sai021/dragon-kingdom/keeper-edition-draft/README.md

# Archived keeper-edition draft

These files preserve a design draft included in the 23 October 2026 checkpoint.
They are not the current firmware interface or user instructions, and the demo
does not constitute physical device evidence.

Edit the active web sources in `../dragon-firmware/web/` and the current manual
in `../docs/USER-MANUAL.md`. See `../docs/PROJECT-STATUS.md` for current evidence
and pending hardware files.
