sai021/dragon-kingdom/dragon-firmware/hardware/supplied-2026-10-23/README.md

# User-supplied hardware files — 23 October 2026

The user supplied these nine files for publication. Original filenames and
bytes are preserved; `SHA256SUMS.txt` records verified attachment checksums.
The BOM and Gerber filenames retain their 21 September 2026 dates. The intake
date does not establish a newer PCB revision or manufacturing approval.

- `BOM_Dragon-Lamp_2_PCB1_1_2026-09-21.xlsx`
- `Gerber_PCB1_1_2026-09-21_2.zip`
- `BackCover 2.stl`
- `UsbNuts 2.stl`
- `Lithophanev2.stl`
- `LithophaneJig.stl`
- `electronicsPlate.stl`
- `LightGuide.stl`
- `NightLamp.f3d` — native Fusion design archive supplied with the exports.

The Fusion archive, six STL exports, BOM and Gerbers are kept together as the
supplied design package. The Fusion file has not been opened to verify component
coverage or external dependencies; completeness for fabrication is not yet checked.

These are supplied assets, not regenerated replacements for earlier prototypes.
Units, orientation, mesh integrity, PCB design checks, optical mapping and
physical fit have not been validated during this intake. Build photos remain
pending. No final-design or manufacturing approval is implied. Existing asset
provenance and licence limitations continue to apply.
