sai021/dragon-kingdom/dragon-firmware/hardware/supplied-2026-10-23/BOM_Dragon-Lamp_2_PCB1_1_2026-09-21.xlsx

No. | Quantity | Comment | Designator | Footprint | Value | Manufacturer Part | Manufacturer | Supplier Part | Supplier
1 | 2 | 100nF | 100nf3,100nf4 | CAP-TH_L5.0-W2.5-P5.00-D1.0 | 100nF | CC1H104MC1FD3F6C10MF | Dersonic(德尔创) | C254085 | LCSC
2 | 1 | HDGCPH254-PW01-08 | J1 | HDR-TH_8P-P2.54-H-M-W10.4 |  | HDGCPH254-PW01-08 | HDGC(华德共创) | C20607071 | LCSC
3 | 1 | HDGCPH254-PW01-10 | J4 | HDR-TH_10P-P2.54-H-M-W10.4 |  | HDGCPH254-PW01-10 | HDGC(华德共创) | C20607072 | LCSC
4 | 1 | 330Ω | r1_330 | RES-TH_BD2.3-L6.3-P10.30-D0.6 | 330Ω | LR1F330R | TE Connectivity(泰科电子) | C1367485 | LCSC
5 | 1 | 10kΩ | r3_10k | RES-TH_BD2.5-L6.5-P10.50-D0.6 | 10kΩ | MFR0W4F1002A50 | UNI-ROYAL(厚声) | C57436 | LCSC
6 | 1 | 100kΩ | r4_100k | RES-TH_BD2.5-L6.5-P10.50-D0.6 | 100kΩ | MFR0W4F1003A50 | UNI-ROYAL(厚声) | C58597 | LCSC
7 | 1 | 20kΩ | r5_20k | RES-TH_BD2.2-L6.5-P10.50-D0.6 | 20kΩ | MFR0W4F2002A50 | UNI-ROYAL(厚声) | C58594 | LCSC
