sai021/dragon-kingdom/dragon-firmware/hardware/supplied-2026-10-23/Lithophanev2.stl

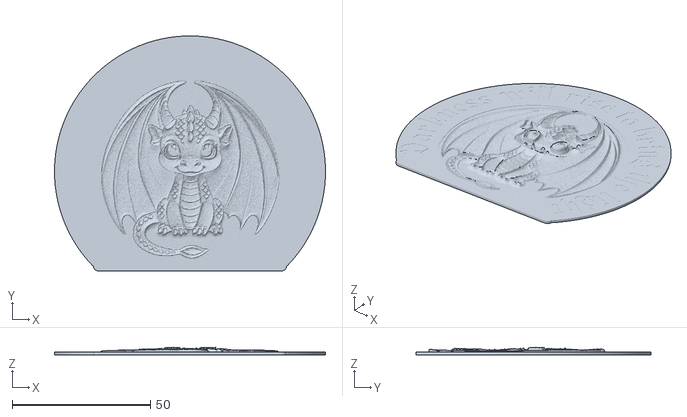
[picture p1: CAD file, 2026-10-23]
dragon-firmware/hardware/supplied-2026-10-23/Lithophanev2.stl
98.0 x 85.0 x 2.74
