sai021/dragon-kingdom/dragon-firmware/hardware/supplied-2026-10-23/BackCover 2.stl

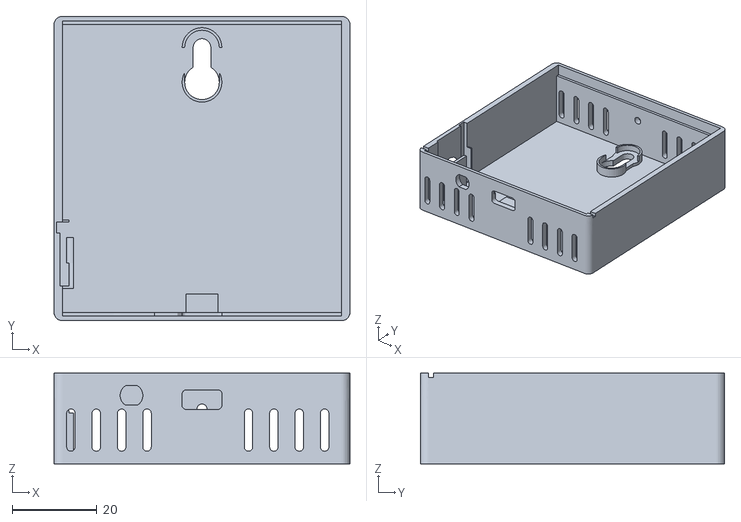
[picture p2: CAD file, 2026-10-23]
dragon-firmware/hardware/supplied-2026-10-23/BackCover 2.stl
70.0 x 72.0 x 21.5
