sai021/dragon-kingdom/dragon-firmware/hardware/supplied-2026-10-23/electronicsPlate.stl

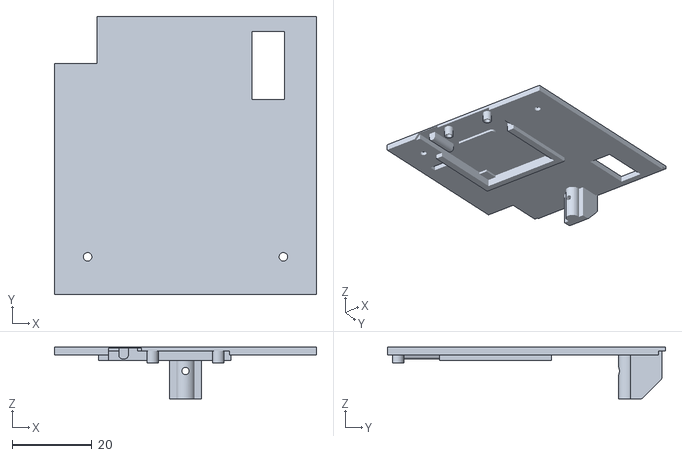
[picture p3: CAD file, 2026-10-23]
dragon-firmware/hardware/supplied-2026-10-23/electronicsPlate.stl
65.6 x 69.6 x 13.0
