sai021/dragon-kingdom/dragon-firmware/hardware/supplied-2026-10-23/LithophaneJig.stl

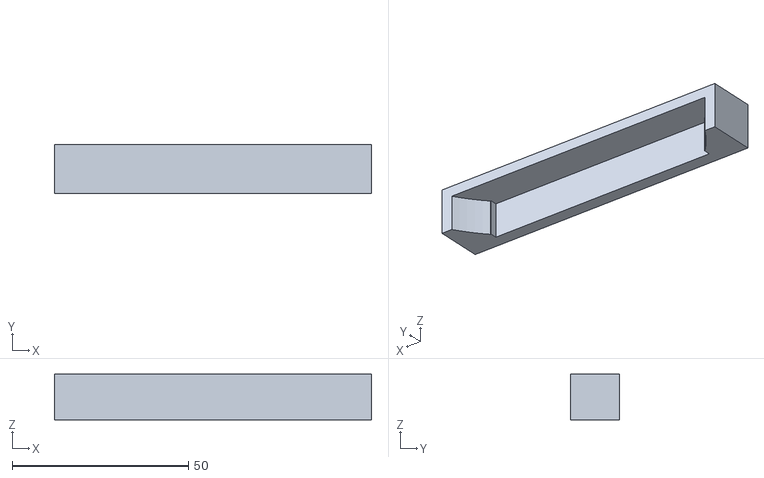
[picture p4: CAD file, 2026-10-23]
dragon-firmware/hardware/supplied-2026-10-23/LithophaneJig.stl
90.0 x 14.0 x 13.0
