sai021/dragon-kingdom/dragon-firmware/hardware/supplied-2026-10-23/UsbNuts 2.stl

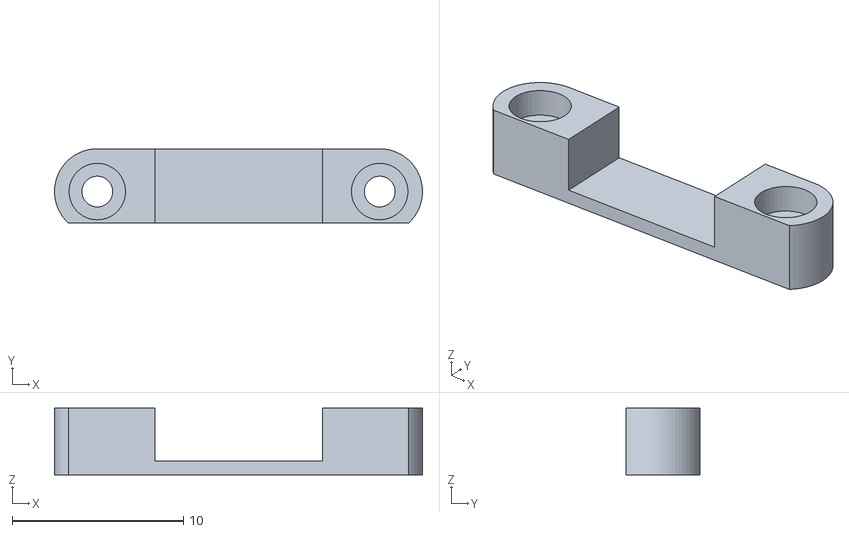
[picture p5: CAD file, 2026-10-23]
dragon-firmware/hardware/supplied-2026-10-23/UsbNuts 2.stl
21.5 x 4.35 x 3.90
