sai021/dragon-kingdom/dragon-firmware/hardware/supplied-2026-10-23/LightGuide.stl

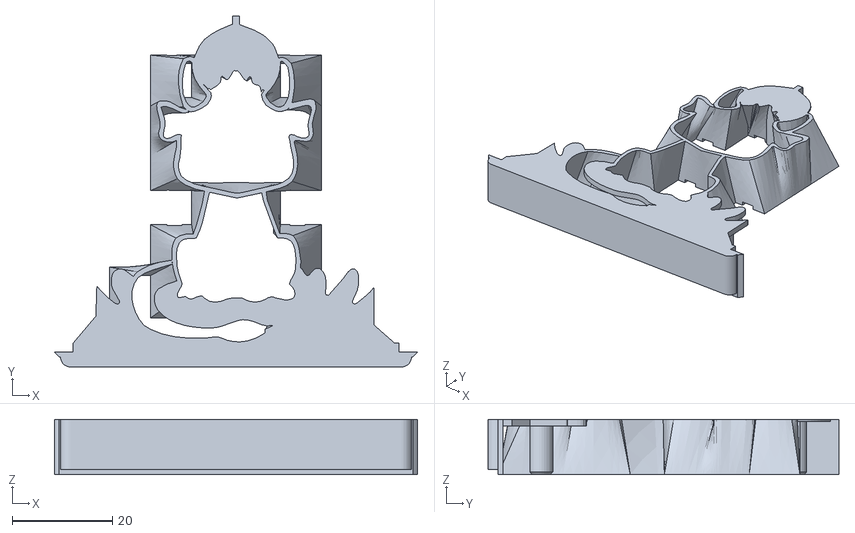
[picture p6: CAD file, 2026-10-23]
dragon-firmware/hardware/supplied-2026-10-23/LightGuide.stl
72.4 x 70.0 x 11.0
