sai021/dragon-kingdom/(list of files, cad)

Other CAD files:
dragon-firmware/hardware/supplied-2026-10-23/NightLamp.f3d
