sai021/dragon-kingdom/keeper-edition-draft/USER-MANUAL.md

# Dragon Kingdom

The Care and Training of Your Wall Dragon — for a young keeper and their grown-ups

## Item 1: Do not plug in your dragon before reading this

Congratulations! You are now the keeper of a genuine, pedigreed **Wall Dragon**. Unlike wild dragons, which take up three bedrooms and set the curtains on fire, a domesticated Wall Dragon needs only a single screw head on a wall and a steady 5 V snack through the USB power port at the bottom.

Your new dragon is a sensitive creature and performs a strict waking ritual whenever power is connected. **Do not rush a waking dragon:**

1. Ask a grown-up to hang your dragon on its wall screw and connect the power supply provided or specified by your maker.
2. Watch its snout: first, it blinks **one dim blue eye five times** to make sure the wall has not moved.
3. Next, it lights a few white bars along the bottom. **It is testing the strength of the cord** so it never drinks more power than your supply can spare. After holding those bars for two seconds of quiet pride, your dragon wakes in full colour.

## Know your dragon (79 breeds in one)

Your dragon didn't hatch out of just any boulder! Because keeping seventy-nine full-sized dragons in one bedroom is frowned upon, your Wall Dragon is trained in **Chameleon Shifting**. With a single pat, it can channel **79 famous dragons** from the tribes—plus up to **eight rare hybrids** invented by you.

**Keep your setup card.** It has your dragon's Wi-Fi name. Its setup password is **dragon123** (all lowercase).

<!-- page -->

# Simple obedience

Section One — basic manners and bedroom etiquette

## Training your dragon

Nobody likes a surly, misbehaving dragon. Limit your early training sessions to fifteen minutes twice a day. Amazingly, a Wall Dragon responds to training without a leash, muzzle, or fire extinguisher.

- **STAY:** Hang your dragon on its wall screw, look it squarely in the snout, and say, **STAY**. Incredibly, your dragon will obey on the very first try. Peek back into the room an hour later and you will find it is still on the wall. Praise your dragon.
- **COME:** Stand across the room and call your dragon's name. Assuming it is properly hung on its screw, it will not move. Do not give up; walk slowly toward the wall. Astonishingly, as you walk toward your dragon, you will notice it coming closer!
- **SPEAK & FETCH:** Don't be ridiculous. Wall Dragons have no ears, no feet, and a deep philosophical objection to barking. They speak entirely in light.

## Your three touch commands

Pat the touch sensor on your dragon to give it commands—no phone or internet required:

- **One pat (Next!):** Shifts into the next dragon in your collection, or wakes a sleeping dragon.
- **Two quick pats (Play Dead / Sleep):** Sends your dragon to sleep in a dark cave, or wakes it back up.
- **Long hold (Purr-Brighten / Dim):** Hold your finger on the pad to adjust its glow in small steps. Let go and hold again to go the other way.

## Nocturnal manners

Your dragon is not afraid of the dark. When you turn off the bedroom lights, it lowers its scales to a steady 10% ember to keep quiet watch while you sleep, and shines at full strength again by day.

<!-- page -->

# Connect a phone

Section Two — telepathy for grown-up keepers

## Open Dragon Kingdom

While your dragon is happy being patted on the nose forever without knowing what the internet is, grown-ups can speak to it through a phone browser. No app or coding is needed.

1. Wait for your dragon to finish its blue-eye waking ritual.
2. Open the phone's Wi-Fi settings and join the dragon network named on its setup card.
3. Enter **dragon123** (all lowercase).
4. If the phone warns that this network has no internet, choose **Stay connected**. (Dragons do not read emails.)
5. Open a browser and type **http://192.168.4.1** in the address bar.
6. Log in with username **parent** and password **dragon123**.

You can play and edit right away over the dragon's own network. Home Wi-Fi is optional. Updated firmware uses **dragon123** even if an older card shows a random password. Your home Wi-Fi keeps its own private password.

## Optional: teach it your home Wi-Fi

1. Open **For grown-ups · Wi-Fi & help** on the phone page.
2. Tap **Find my Wi-Fi**, then pick your **2.4 GHz** home network (or type its name if hidden).
3. Enter your home Wi-Fi password. Use **Show password** to check your spelling.
4. Tap **Connect my dragon** and wait for the result.
5. Copy the **.local** bookmark address that appears above the play controls (such as **http://Dragon-Kingdom-a1b2c3.local/**).
6. Switch your phone back to home Wi-Fi, open that address, and bookmark it. The page also shows a numeric fallback address.

<!-- page -->

# The dawn stretch

Section Three — teaching your dragon rooster duty

## Set your wake-up time

Roosters are noisy and drop feathers on the floor. A trained Wall Dragon wakes you silently by painting the wall behind its wings with sunrise light.

1. Open **Sunrise alarm** on the phone page and wait for its saved schedule to load.
2. Tick **Wake me every day**.
3. Choose your **Wake-up time** and **Sunrise length (minutes)**.
4. Tap **Save alarm** and check the confirmation message.

Your dragon begins warming its entire wings—from the lowest wing scales to the wing tips—from deep ember-orange to morning gold before wake-up time. For example, **7:00** with a **20-minute** sunrise starts at **6:40**.

It works even while the dragon is asleep. At wake-up time, the wings hold their morning glow for **30 minutes**, then return to their previous state. Available power still caps brightness, and the dragon never makes a sound.

## Rehearse or dismiss the sunrise

- **Try a 30-second sunrise** previews the dawn stretch, then returns to normal after a brief hold.
- **Stop sunrise** (or any pat / play button) tells your dragon "I'm awake!" without cancelling tomorrow's alarm.
- To turn off rooster duty completely, untick **Wake me every day** and tap **Save alarm**.

## Dragon timekeeping

Dragons do not wear wristwatches. Saving an alarm borrows the clock and daylight-saving rules from your phone. If unplugged, the dragon remembers your schedule, but after a power cut it needs home Wi-Fi internet time or this page opened again (**Set clock from my phone**) before it knows what hour it is. Open and save the alarm once a year or after changing time zones.

<!-- page -->

# Roosts and collections

Section Four — The Great Sanctuary and personal teams

## All or a personal roost

Every dragon lives in **All** (The Great Sanctuary). It holds all 79 pedigreed dragons plus every custom hybrid ever hatched on your device. By ancient dragon law, **All** cannot be renamed or deleted, and you can use it forever without making a profile.

If you want smaller hand-picked teams for different moods, use **My profile** to switch between up to **three named profiles** (personal roosts).

When a named profile is active, **My dragon** and single pats on the touch sensor cycle only through that profile's favourites and its own creations. The first dragon in the list greets you after startup.

## Build a personal roost

1. Open **My favourites & starting glow**.
2. Enter a **New profile name** and tap **Add profile**.
3. Tick up to **12** favourite dragons in the order you want them to appear. (Untick and tick again to move one to the end.)
4. Pick a **Starting glow**, then tap **Save profile**.

Your own creations appear right after your ticked favourites. A brand-new empty profile will say **Add favourites or make a dragon**, and play buttons rest until you put at least one dragon in that roost. Profiles and creations survive unplugging; temporary play tricks do not overwrite your saved startup glow.

## Closing a roost

To remove a named profile, select it, open its settings, and tap **Delete this profile**. Never worry about losing your hybrids: any custom dragons hatched in that roost fly safely back into **All**.

<!-- page -->

# Hatching a hybrid

Section Five — custom colours, body parts and elemental tricks

## Breed and save your own dragon

1. Tap **Make a dragon** and choose a starter breed in **Start from**.
2. Give your creation a **Dragon name**.
3. Tap a body region on the dragon picture, or pick one from **Dragon part**.
4. Choose its **Colour** and **Magic on this part** (such as Glitter, Shimmer, Breathe, or Rainbow).
5. Paint as many parts as you like, then tap **Save my dragon**.

You can colour the **face, body, tail, horns, wing edges, and wing interiors** separately. Untouched parts keep their natural markings, and **Use original colour for this part** restores a region's base scales.

Use the view switch under the picture to see your dragon's sculpted outline, the 64 lights, or both together. Tap **Save my dragon** to watch your creation come alive on the wall!

## Edit, copy, or retire a hybrid

- Select your dragon in **My dragon** and tap **Make a dragon** to groom or rename it.
- **Save my dragon** updates a hybrid you own; **Save a new copy** hatches a twin.
- Editing one of the 79 pedigreed dragons (or a hybrid from another profile) always saves a new copy so originals stay untouched.
- Your wall holds up to **eight custom dragons** in total. When all eight perches are full, edit or delete an old creation to make room.

## Amusing elemental tricks

On the play screen, tap **Glitter**, **Fire**, **Breathe**, or **Rainbow**. Your dragon will perform the trick tirelessly until you tap **Back to my dragon**. Use **Glow** to adjust brightness, or **Sleep / Wake my dragon** for nap time. Wait a beat for each trick to land before tapping the next button.

<!-- page -->

# Dragon health care

Section Six — moving house and first aid for common ailments

## Moving house (The Purple Nose-Hold)

If you change Wi-Fi routers or want a direct phone connection again, teach your dragon the **Purple Nose-Hold**:

1. Unplug the power cord from the bottom of the dragon.
2. Press and hold your finger on the touch pad while plugging the power back in.
3. Keep holding right through the five blue eye-blinks.
4. Let go when the dragon glows **purple** after startup.
5. Join the **Dragon-Kingdom-XXXXXX** Wi-Fi network with **dragon123** and open **http://192.168.4.1**.

This keeps your saved home Wi-Fi and creations intact. To erase home Wi-Fi completely, tap **Forget home Wi-Fi** in the grown-ups section.

## When your dragon seems confused

- **Phone says "no internet":** Completely normal on the dragon's private network. Stay connected and open **http://192.168.4.1**.
- **The .local bookmark won't open:** Make sure your phone is on the same home Wi-Fi as the dragon, or try its numeric address. Guest networks often forbid pets from talking to phones—use a regular home network or the Purple Nose-Hold.
- **Dragon Wi-Fi never appears:** If the power brick is weak, the dragon saves its energy for touch lighting and keeps Wi-Fi off. Ask a grown-up to check the power supply specified by the maker.
- **Page says "Please wait for your dragon":** You are tapping faster than a dragon can think! Let the current action finish.
- **Dragon is unexpectedly dark or blinking red:** Check **Sleep** and **Glow** first (remember it dims in dark rooms). If it shows a dim red code at startup or keeps restarting, unplug it and contact the maker.
- **Interrupted saves or lost time:** A failed save keeps your draft open in the editor. If the page asks to reload after a firmware update or collection change, note your unsaved colour choices first. If the alarm waits after a power cut, tap **Set clock from my phone**.

<!-- page -->

# Keeper's certificate

Section Seven — care rules and official registration

## Feeding and care (For grown-ups)

Always feed your dragon through the bottom USB power port using the power supply provided or specified by your maker. Keep your dragon indoors and dry, handle its cord gently, and never open its enclosure or attach unapproved power sources.

## A good dragon keeper remembers

Carved across your dragon's frame is the motto **Darkness will rise to bring the light**—every hard climb or quiet night comes right before you shine.

- **Touch play always works**—even without a phone, Wi-Fi, or internet.
- **Keep your setup card** and bookmark your dragon's **.local** address.
- **All** is the protected Great Sanctuary; named profiles are personal roosts.
- **Save your work** in the editor before unplugging the dragon.
- **Polite brightness:** Your dragon automatically adjusts its glow for dark bedrooms and the strength of its power supply, so 100% means "as bright as current conditions safely allow."
- Never throw your dragon across a pond, and never turn it loose in the wild. Remember: if you take care of your Wall Dragon, your Wall Dragon will chase away the dark for you.

## Official pedigree record

First dragon's name: ____________________________________

Keeper's name: __________________________________________

Phone bookmark (.local): ________________________________

Maker / Dragon healer contact: __________________________

Dragon Wi-Fi & browser password: **dragon123** (Browser username: **parent**). Keep your home Wi-Fi password private.

**About this edition:** Dragon Kingdom prototype user manual, version 0.5, 19 October 2026. It describes the current software interface while final enclosure details are completed by your maker.
