sai021/dragon-kingdom/output/setup/dragon-rear-labels.pdf

# Dragon Kingdom | shared rear labels

Print at 100% / Actual size. Cut on the outlines. Each label is 90 x 65 mm. Check space on your finished enclosure before printing adhesive stock.

## DRAGON KINGDOM

### Setup & manual Needs internet

### Open dragon Join dragon Wi-Fi first

Wi-Fi: Dragon-Kingdom-... | Password: dragon123
Play: no login | Parent settings: dragon123

## DRAGON KINGDOM

### Setup & manual Needs internet

### Open dragon Join dragon Wi-Fi first

Wi-Fi: Dragon-Kingdom-... | Password: dragon123
Play: no login | Parent settings: dragon123

## DRAGON KINGDOM

### Setup & manual Needs internet

### Open dragon Join dragon Wi-Fi first

Wi-Fi: Dragon-Kingdom-... | Password: dragon123
Play: no login | Parent settings: dragon123

## DRAGON KINGDOM

### Setup & manual Needs internet

### Open dragon Join dragon Wi-Fi first

Wi-Fi: Dragon-Kingdom-... | Password: dragon123
Play: no login | Parent settings: dragon123

## DRAGON KINGDOM

### Setup & manual Needs internet

### Open dragon Join dragon Wi-Fi first

Wi-Fi: Dragon-Kingdom-... | Password: dragon123
Play: no login | Parent settings: dragon123

## DRAGON KINGDOM

### Setup & manual Needs internet

### Open dragon Join dragon Wi-Fi first

Wi-Fi: Dragon-Kingdom-... | Password: dragon123
Play: no login | Parent settings: dragon123
