sai021/dragon-kingdom/output/setup/dragon-setup-card.pdf

# Welcome, dragon keeper!

One card for every dragon. No app or account needed.

### 1. Read first. Scan Setup & manual while your phone has internet. Then

power on one new dragon and wait for it to wake.

### 2. Join your dragon. In phone Wi-Fi settings, choose a network starting

Dragon-Kingdom-. Password: dragon123. If asked, stay connected without internet.

### 3. Open controls. The setup page may appear automatically. Otherwise scan

Open dragon below. Play needs no login. Unlock Parent settings with dragon123.

Setup & manual
Needs internet

Open dragon
Join dragon Wi-Fi first

My dragon's Wi-Fi name (optional) Dragon-Kingdom-________________

Several dragon networks? Power off the others while setting up. Home Wi-Fi is optional; after joining it, bookmark the address shown in the controls.

Need setup again? Power off and on normally. Setup Wi-Fi opens at startup; no touch hold needed. Bottom USB-C is power-only.

QR fallback after joining dragon Wi-Fi: http://192.168.4.1/
Manual: sai021.github.io/dragon-kingdom/manual.pdf
