sai021/dragon-kingdom/dragon-firmware/DragonPrototype/UpdatePublicKey.h

#pragma once
// Public release verification key. Private key is never shipped.
static const char DRAGON_UPDATE_PUBLIC_KEY[]=R"KEY(-----BEGIN PUBLIC KEY-----
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
fQIDAQAB
-----END PUBLIC KEY-----
)KEY";
