sai021/dragon-kingdom/dragon-firmware/tools/recovery.py

"""USB-only migration/recovery. Preserve and verify the original NVS partition."""
import argparse, json, struct, subprocess, time, os, re, hashlib
from pathlib import Path
from release_contract import verify as verify_contract
from board_targets import TARGETS, detect_board, parse_chip
from flash_support import ROOT, FILES, load_bundle, digest, check_startup, serial_modules

def validate_partitions(raw):
    entries={}
    for at in range(0,len(raw)-31,32):
        magic,kind,sub,offset,size,label,flags=struct.unpack('<HBBII16sI',raw[at:at+32])
        if magic!=0x50aa:break
        entries[label.rstrip(b'\0').decode('ascii')]=(kind,sub,offset,size)
    expected={'nvs':(1,2,0x9000,0x5000),'otadata':(1,0,0xe000,0x2000),'app0':(0,0x10,0x10000,0x180000),'app1':(0,0x11,0x190000,0x180000)}
    if any(entries.get(k)!=v for k,v in expected.items()):raise ValueError('Recovery requires the new two-slot partition layout with unchanged NVS offset and size.')
    return entries

def validate_image_target(raw,board):
    if len(raw)<24 or raw[0]!=0xe9 or int.from_bytes(raw[12:14],'little')!={'s3':9,'c3':5}[board]:
        raise ValueError('Recovery image does not match the detected ESP32 board. Nothing was written.')

def validate_current_nvs(raw):
    for at in range(0,len(raw)-31,32):
        magic,kind,sub,offset,size,label,flags=struct.unpack('<HBBII16sI',raw[at:at+32])
        if magic!=0x50aa:break
        if label.rstrip(b'\0')==b'nvs':
            if (kind,sub,offset,size)==(1,2,0x9000,0x5000):return
            raise ValueError('Connected board has a different NVS layout. Nothing was written.')
    raise ValueError('Could not verify the connected board NVS layout. Nothing was written.')

def esptool_path(cli):
    result=subprocess.run([cli,'board','details','--fqbn',TARGETS['s3'],'--format','json'],capture_output=True,text=True,check=True,timeout=30)
    props=dict(v.split('=',1) for v in json.loads(result.stdout)['build_properties'] if '=' in v)
    return Path(props['runtime.tools.esptool_py.path'])/props['tools.esptool_py.cmd']

def installed_esptool():
    # Prefer the installed Espressif standalone tool; Arduino CLI may be blocked.
    base=Path(os.environ.get('LOCALAPPDATA',str(Path.home()/'AppData/Local')))/'Arduino15/packages/esp32/tools/esptool_py'
    candidates=list(base.glob('*/esptool.exe'))
    return max(candidates,key=lambda p:tuple(int(n) for n in re.findall(r'\d+',p.parent.name))) if candidates else None

def image_app_digest(raw):
    if len(raw)<56 or raw[23]!=1 or hashlib.sha256(raw[:-32]).digest()!=raw[-32:]:raise ValueError('Application lacks a valid appended ESP image digest')
    return raw[-32:].hex()

def release_image_digest(cache,board):
    build=load_bundle(cache=cache or ROOT/'.tools/recovery-release',board=board)
    return image_app_digest((build/FILES[0]).read_bytes())

def prepared_release(cache=None):
    cache=cache or ROOT/'.tools/recovery-release'
    info=verify_contract(json.loads((cache/'current-set.json').read_text(encoding='utf-8')))
    for board in TARGETS:
        build=load_bundle(cache=cache,board=board);validate_partitions((build/FILES[2]).read_bytes())
        for name in FILES[:2]:validate_image_target((build/name).read_bytes(),board)
        image_app_digest((build/FILES[0]).read_bytes())
    return info


def install_fresh(port,usb_only,replace_existing=False,emit=print,cache=None,tool=None,backup_decision=None):
    """Initialize a proven-empty board, or explicitly replace one after full backup."""
    if not usb_only:raise ValueError('Disconnect external/main power before USB installation.')
    info=prepared_release(cache)
    tool=tool or installed_esptool()
    if not tool:raise ValueError('USB tool is unavailable.')
    session=ROOT/'.tools/recovery'/('fresh-'+time.strftime('%Y%m%d-%H%M%S')+'-'+os.urandom(4).hex())
    session.mkdir(mode=0o700,parents=True,exist_ok=False)
    board=None;complete=False
    def command(*args,timeout=600):
        result=subprocess.run([str(tool),'--chip',('esp32'+board) if board else 'auto','--port',port,
                               '--baud','460800','--after','no-reset',*map(str,args)],capture_output=True,text=True,timeout=timeout)
        if result.returncode:raise RuntimeError('USB installation stopped. Keep the private flash backup. '+result.stderr[-700:])
        return result.stdout+result.stderr
    try:
        emit('Identifying board and flash size...')
        details=command('flash-id',timeout=35);board=parse_chip(details)
        size=re.search(r'Detected flash size:\s*(\d+)\s*MB',details,re.I)
        if not size or int(size[1]) not in (4,8,16):raise ValueError('Fresh installation supports verified 4, 8 or 16 MB flash only. Nothing was erased.')
        length=int(size[1])*1024*1024
        build=load_bundle(board=board,cache=cache or ROOT/'.tools/recovery-release')
        validate_partitions((build/FILES[2]).read_bytes())
        for name in FILES[:2]:validate_image_target((build/name).read_bytes(),board)
        before=session/'flash-before.bin';check=session/'flash-verify.bin'
        backup_available=False;blank=False
        try:
            emit('Saving a full private flash backup; this can take a few minutes...')
            command('read-flash','0',hex(length),before)
            if before.stat().st_size!=length:raise ValueError('Full flash backup is incomplete.')
            emit('Verifying the flash backup...')
            command('read-flash','0',hex(length),check)
            if check.stat().st_size!=length or digest(before)!=digest(check):raise ValueError('Flash backup verification failed.')
            backup_available=True;blank=before.read_bytes()==b'\xff'*length
        except Exception as error:
            message='A verified flash backup could not be made. Continuing will install Dragon Kingdom and replace the existing firmware and saved data without a recoverable backup. '+str(error)
            if backup_decision is None or not backup_decision(message):raise ValueError('Backup unavailable. Installation aborted before erasing or writing.') from error
            replace_existing=True
            emit('User chose Continue without backup. Installing without a verified backup.')
        if not blank and not replace_existing:
            message='The existing firmware or saved-data format is not recognized, so a compatible Dragon backup is unavailable. Continuing will replace the existing firmware and saved data. A raw flash snapshot was saved privately, but it is not a compatible Dragon settings backup.'
            if backup_decision is None or not backup_decision(message):raise ValueError('Installation aborted before erasing or writing.')
            replace_existing=True
            emit('User chose Continue without backup for unidentified firmware.')
        (session/'evidence.json').write_text(json.dumps({'board':board,'size':length,'sha256':digest(before) if backup_available else None,'empty':blank,'replacement_selected':replace_existing,'backup_available':backup_available,'firmware_tag':info['firmware_tag']},indent=2),encoding='utf-8')
        if not blank:
            emit('Fresh installation selected. Erasing the previous contents...')
            command('erase-flash')
        else:emit('Entire flash is verified empty. Installing Dragon Kingdom...')
        ota=session/'otadata-reset.bin';ota.write_bytes(b'\xff'*0x2000)
        command('write-flash','0x0',build/FILES[1],'0x8000',build/FILES[2],'0xe000',ota,'0x10000',build/FILES[0])
        if backup_available:
            nvs=session/'nvs-before-first-boot.bin';command('read-flash','0x9000','0x5000',nvs)
            if nvs.read_bytes()!=b'\xff'*0x5000:raise ValueError('New saved-data area was not erased. Retain the backup and stop.')
        emit('Signed firmware written. Checking first startup...')
        subprocess.run([str(tool),'--chip','esp32'+board,'--port',port,'--no-stub','--after','hard-reset','chip-id'],capture_output=True,text=True,timeout=35,check=True)
        check_startup(port,emit,timeout=90,expected_firmware=info['firmware_tag'],require_validation=True,
                      expected_board=board,production=True,expected_image_sha256=release_image_digest(cache,board))
        complete=True
        return 'Updated '+('empty board' if blank else 'by fresh installation')+' to '+info['firmware_tag']+'. Startup verified. '+('Full backup: '+str(before) if backup_available else 'Continued without a verified backup.')
    finally:
        if not complete and board:
            # A read-only rejection should not leave an existing lamp in ROM mode.
            try:subprocess.run([str(tool),'--chip','esp32'+board,'--port',port,'--no-stub','--after','hard-reset','chip-id'],capture_output=True,text=True,timeout=35)
            except Exception:pass

def recover(cli,port,usb_only,emit=print,cache=None,tool=None,source_schema=None,backup_decision=None):
    if not usb_only:raise ValueError('Disconnect external/main power before internal laptop USB recovery.')
    info=prepared_release(cache) # Signed compatibility, hashes and layout before any device write.
    check_source_compatibility(port,info['saved_schema'],source_schema)
    if tool:
        probe=subprocess.run([str(tool),'--chip','auto','--port',port,'--baud','115200','--after','no-reset','chip-id'],capture_output=True,text=True,timeout=30,check=True)
        board=parse_chip(probe.stdout+probe.stderr)
    else:board=detect_board(cli,port)
    emit('Verified ESP32-'+board.upper())
    build=load_bundle(board=board,cache=cache or ROOT/'.tools/recovery-release')
    validate_partitions((build/FILES[2]).read_bytes())
    for name in FILES[:2]:validate_image_target((build/name).read_bytes(),board)
    tool=Path(tool) if tool else esptool_path(cli);session=ROOT/'.tools/recovery'/time.strftime('%Y%m%d-%H%M%S');session.mkdir(parents=True,exist_ok=False)
    def run(*args):
        result=subprocess.run([str(tool),'--chip','esp32'+board,'--port',port,'--after','no-reset',*map(str,args)],capture_output=True,text=True,timeout=180)
        if result.returncode:raise RuntimeError('Recovery operation failed. Keep USB connected and retain the local NVS backup. '+result.stderr[-1000:])
    live_table=session/'partitions-before.bin';run('read-flash','0x8000','0x1000',live_table);validate_current_nvs(live_table.read_bytes())
    before=session/'nvs-before.bin';after=session/'nvs-after.bin'
    emit('Backing up saved data locally. This file contains credentials; keep it private.')
    backup_available=False
    try:
        run('read-flash','0x9000','0x5000',before)
        if before.stat().st_size!=0x5000:raise RuntimeError('NVS backup is incomplete.')
        backup_available=True
    except Exception as error:
        message='The saved-data backup could not be made. Continuing updates the firmware without a verified backup; saved data cannot be checked afterward. '+str(error)
        if backup_decision is None or not backup_decision(message):raise RuntimeError('Backup unavailable. Update aborted before writing firmware.') from error
        (session/'backup-unavailable.json').write_text('{"verified_backup":false,"continued_by_user":true}',encoding='utf-8')
        emit('User chose Continue without backup. Saved-data verification will be unavailable.')
    # These ranges exclude 0x9000..0xDFFF. No erase-flash, merged image or NVS write.
    ota=session/'otadata-reset.bin';ota.write_bytes(b'\xff'*0x2000)
    emit('Writing verified board image and two-slot layout. Keep USB connected.')
    run('write-flash','0x0',build/FILES[1],'0x8000',build/FILES[2],'0xe000',ota,'0x10000',build/FILES[0])
    if backup_available:
        run('read-flash','0x9000','0x5000',after)
        if digest(before)!=digest(after):raise RuntimeError('Saved-data verification FAILED. Keep the NVS backup; do not claim successful migration.')
        emit('Saved NVS bytes verified unchanged. Resetting for startup checks.')
    else:emit('No verified backup available. Resetting for firmware startup checks.')
    subprocess.run([str(tool),'--chip','esp32'+board,'--port',port,'--no-stub','--after','hard-reset','chip-id'],capture_output=True,text=True,timeout=30,check=True)
    emit('Waiting for firmware startup validation. This can take about a minute.')
    check_startup(port,emit,timeout=75,expected_firmware=info.get('firmware_tag'),require_validation=True,expected_board=board,production=True,expected_image_sha256=release_image_digest(cache,board))
    emit('Recovery complete. Keep USB-only power until unplugged. Setup Wi-Fi opens at startup.')
    return session

def verify_production_startup(port,emit=print,cache=None,tool=None):
    info=prepared_release(cache);tool=tool or installed_esptool()
    if not tool:raise ValueError('Installed esptool required')
    probe=subprocess.run([str(tool),'--chip','auto','--port',port,'--after','no-reset','chip-id'],capture_output=True,text=True,timeout=30,check=True)
    board=parse_chip(probe.stdout+probe.stderr)
    subprocess.run([str(tool),'--chip','esp32'+board,'--port',port,'--no-stub','--after','hard-reset','chip-id'],capture_output=True,text=True,timeout=30,check=True)
    return check_startup(port,emit,timeout=75,expected_firmware=info['firmware_tag'],require_validation=True,expected_board=board,production=True,expected_image_sha256=release_image_digest(cache,board))

def firmware_version(tag):
    match=re.fullmatch(r'v(\d+)\.(\d+)\.(\d+)(?:-beta\.(\d+))?',tag or '')
    if not match:raise ValueError('Unrecognised firmware version; use manual recovery instead of Auto.')
    major,minor,patch,beta=match.groups()
    return (int(major),int(minor),int(patch),1 if beta is None else 0,int(beta or 0))

def compatible_source(tag,schema,target_schema):
    if schema is None:
        # Only explicitly known published legacy versions have this historical contract.
        known={'v0.2.4-prototype','v0.3.0','v0.3.0-beta.1','v0.3.0-beta.2','v0.3.0-beta.3'}
        if tag not in known:raise ValueError('Source saved-data schema is unknown. Retain a private NVS dump and review the installed source before explicit service recovery with --source-schema 1.')
        schema=1
    if schema!=target_schema:raise ValueError('Saved-data schema is incompatible. Nothing was written.')

def check_source_compatibility(port,target_schema,source_schema=None):
    if source_schema is not None:
        compatible_source(None,source_schema,target_schema);return
    serial,_=serial_modules();connection=serial.Serial(port=None,baudrate=115200,timeout=.2,write_timeout=1)
    connection.dtr=True;connection.rts=False;connection.port=port
    tag=None;schema=None;reports=0;last=0;deadline=time.monotonic()+18
    try:
        connection.open();connection.reset_input_buffer()
        while time.monotonic()<deadline:
            if time.monotonic()-last>=1:connection.write(b'status\n');last=time.monotonic()
            line=connection.readline().decode('utf-8',errors='replace').strip()
            if line.startswith('firmware_version='):tag=line.split()[0].split('=',1)[1]
            match=re.match(r'firmware_compatibility schema=(\d+)\b',line)
            if match:schema=int(match[1])
            if line.startswith('uptime_ms='):
                reports+=1
                if schema is not None or reports>=2:compatible_source(tag,schema,target_schema);return
        raise ValueError('Cannot establish source schema from runtime. Use the documented evidence-preserving service recovery procedure.')
    finally:connection.close()

def read_running_version(port,timeout=18):
    # Status output may contain user data. Keep it in memory and emit only the version.
    serial,_=serial_modules();connection=None;deadline=time.monotonic()+timeout;last=0;uptimes=0
    try:
        while time.monotonic()<deadline:
            try:
                if connection is None:
                    connection=serial.Serial(port=None,baudrate=115200,timeout=.2,write_timeout=1)
                    connection.dtr=True;connection.rts=False;connection.port=port;connection.open();connection.reset_input_buffer()
                if time.monotonic()-last>=1:connection.write(b'status\n');last=time.monotonic()
                line=connection.readline().decode('utf-8',errors='replace').strip()
                if line.startswith('firmware_version='):return line.split()[0].split('=',1)[1]
                if line.startswith('uptime_ms='):
                    uptimes+=1
                    if uptimes>=2:return None # Legacy firmware has no version status field.
            except (serial.SerialException,OSError):
                if connection:connection.close()
                connection=None;time.sleep(.2)
        raise RuntimeError('Could not read the running firmware. Release BOOT, reset and retry Auto, or use manual recovery.')
    finally:
        if connection:connection.close()

def update_if_newer(cli,port,usb_only,emit=print,cache=None,tool=None,backup_decision=None):
    if not usb_only:raise ValueError('Disconnect external/main power before enabling Auto.')
    info=prepared_release(cache);target=info.get('firmware_tag');wanted=firmware_version(target)
    tool=tool or installed_esptool() or esptool_path(cli)
    emit('Reading the connected firmware version...');current=read_running_version(port)
    if current is not None:
        running=firmware_version(current);emit('Running '+current+'; prepared '+target+'.')
        if running>wanted:raise ValueError('Connected firmware is newer than the selected production release. Select its matching signed bundle; no write or production pass.')
        if running==wanted:
            # Still identify the ROM and verify a healthy startup; skip all flash writes.
            probe=subprocess.run([str(tool),'--chip','auto','--port',port,'--baud','115200','--after','no-reset','chip-id'],capture_output=True,text=True,timeout=30,check=True)
            board=parse_chip(probe.stdout+probe.stderr);emit('Verified ESP32-'+board.upper()+'. No newer firmware; no flash write required.')
            subprocess.run([str(tool),'--chip','esp32'+board,'--port',port,'--no-stub','--after','hard-reset','chip-id'],capture_output=True,text=True,timeout=30,check=True)
            check_startup(port,emit,timeout=75,expected_firmware=current,require_validation=True,expected_board=board,production=True,expected_image_sha256=release_image_digest(cache,board))
            return 'Already current or newer; startup verified.'
    else:emit('Legacy or unreported firmware version: applying the prepared recovery firmware.')
    session=recover(cli,port,usb_only,emit,cache=cache,tool=tool,backup_decision=backup_decision)
    return 'Updated to '+target+'; startup verified.'+(' Continued without a verified backup; saved data not verified.' if isinstance(session,Path) and (session/'backup-unavailable.json').exists() else '')


def main():
    p=argparse.ArgumentParser(description=__doc__);p.add_argument('--port',required=True);p.add_argument('--cli',default=str(ROOT/'.tools/arduino-cli/arduino-cli.exe'));p.add_argument('--esptool',type=Path,help='Use an installed standalone esptool, without Arduino CLI');p.add_argument('--usb-only',action='store_true');p.add_argument('--bundle',type=Path,required=True,help='Explicit immutable signed release directory');p.add_argument('--source-schema',type=int,choices=[1],help='Service-only assertion after private NVS backup and source-schema review when runtime is unavailable');a=p.parse_args()
    recover(a.cli,a.port,a.usb_only,tool=a.esptool or installed_esptool(),cache=a.bundle,source_schema=a.source_schema)

if __name__=='__main__':main()
