sai021/dragon-kingdom/dragon-firmware/tests/test_release_tools.py

import hashlib, json, struct, sys, tempfile, unittest
from pathlib import Path
from unittest.mock import patch
sys.path.insert(0,str(Path(__file__).resolve().parents[1]/'tools'))
import recovery
import flash_support
from types import SimpleNamespace
from unittest.mock import Mock
import itertools
import sign_update
from cryptography.exceptions import InvalidSignature
from cryptography.hazmat.primitives import hashes
from cryptography.hazmat.primitives.asymmetric import rsa,padding

def partition_table():
    entries=[('nvs',1,2,0x9000,0x5000),('otadata',1,0,0xe000,0x2000),('app0',0,0x10,0x10000,0x180000),('app1',0,0x11,0x190000,0x180000)]
    return b''.join(struct.pack('<HBBII16sI',0x50aa,t,sub,at,size,name.encode(),0) for name,t,sub,at,size in entries)+b'\xff'*32

class ReleaseTests(unittest.TestCase):
    def test_real_rsa_signature_binds_board_size_and_image_digest(self):
        with tempfile.TemporaryDirectory() as temp:
            image=Path(temp)/'image.bin';image.write_bytes(b'firmware image')
            key=rsa.generate_private_key(public_exponent=65537,key_size=2048)
            pkg=sign_update.package(image,'s3',key);signature=bytes.fromhex(pkg['signature'])
            key.public_key().verify(signature,sign_update.canonical('s3',pkg['size'],pkg['sha256']),padding.PKCS1v15(),hashes.SHA256())
            for board,size,digest in [('c3',pkg['size'],pkg['sha256']),('s3',pkg['size']+1,pkg['sha256']),('s3',pkg['size'],'0'*64)]:
                with self.assertRaises(InvalidSignature):key.public_key().verify(signature,sign_update.canonical(board,size,digest),padding.PKCS1v15(),hashes.SHA256())
            self.assertEqual(hashlib.sha256(bytes.fromhex(pkg['image'])).hexdigest(),pkg['sha256'])
    def test_v2_signature_binds_compatibility_and_tag(self):
        key=rsa.generate_private_key(public_exponent=65537,key_size=2048)
        message=sign_update.canonical('c3',512,'0'*64,'v0.3.1',1,1)
        signature=key.sign(message,padding.PKCS1v15(),hashes.SHA256())
        key.public_key().verify(signature,message,padding.PKCS1v15(),hashes.SHA256())
        for altered in [message.replace(b'v0.3.1',b'v0.3.2'),message[:-4]+b'0\n1\n',message[:-2]+b'2\n']:
            with self.assertRaises(InvalidSignature):key.public_key().verify(signature,altered,padding.PKCS1v15(),hashes.SHA256())

    def test_production_rejects_zero_budget_and_missing_contract(self):
        with self.assertRaises(RuntimeError):flash_support.StartupEvidence(production=True).observe('uptime_ms=10000 session_max=0mA computer_usb_cap=1 voltage_sampling=stopped')
        with self.assertRaises(ValueError):flash_support.check_startup('unused',print,production=True)

    def test_signed_usb_contract_rejects_tampering_missing_capability_and_schema(self):
        import release_contract
        key=rsa.generate_private_key(public_exponent=65537,key_size=2048)
        info={'contract':2,'firmware_tag':'v0.3.1','source_commit':'a'*40,'saved_schema':1,'capabilities':1,'targets':{'c3':{'sha256':'a'*64}}}
        def sign(value):return {**value,'signature':key.sign(release_contract.canonical(value),padding.PKCS1v15(),hashes.SHA256()).hex()}
        with patch.object(release_contract,'public_key',return_value=key.public_key()):
            signed=sign(info);release_contract.verify(signed)
            with self.assertRaises(InvalidSignature):release_contract.verify({**signed,'firmware_tag':'v0.3.2'})
            with self.assertRaises(ValueError):release_contract.verify(sign({**info,'saved_schema':2}))
            with self.assertRaises(ValueError):release_contract.verify(sign({**info,'capabilities':0}))
            with self.assertRaises(KeyError):release_contract.verify(info)

    def test_release_preparation_is_immutable_and_binds_fresh_provenance(self):
        import prepare_release,release_contract
        from cryptography.hazmat.primitives import serialization
        key=rsa.generate_private_key(public_exponent=65537,key_size=2048)
        with tempfile.TemporaryDirectory() as temp:
            root=Path(temp);builds=root/'build';output=root/'release';keyfile=root/'test-key.pem'
            keyfile.write_bytes(key.private_bytes(serialization.Encoding.PEM,serialization.PrivateFormat.PKCS8,serialization.NoEncryption()))
            (root/'DragonPrototype').mkdir();(root/'DragonPrototype/OnlinePolicy.h').write_text('constexpr const char* CURRENT_TAG="v0.3.0-beta.4";')
            for board in recovery.TARGETS:
                build=builds/board;build.mkdir(parents=True)
                raw=b'\xe9'+b'\0'*11+bytes([9 if board=='s3' else 5,0])+b'\0'*9+b'\1'+b'test app'
                for name in recovery.FILES[:2]:(build/name).write_bytes(raw+hashlib.sha256(raw).digest())
                (build/recovery.FILES[2]).write_bytes(partition_table())
                (build/'build.options.json').write_text(json.dumps({'fqbn':recovery.TARGETS[board]}))
                (build/'provenance.json').write_text(json.dumps({'source_commit':'a'*40,'source_sha256':'b'*64,'board':board,'toolchain':'esp32:esp32@3.2.1;Adafruit NeoPixel@1.12.5','sha256':{name:flash_support.digest(build/name) for name in recovery.FILES}}))
            def git(args,**kwargs):return 'a'*40 if 'rev-parse' in args else ''
            with patch.object(prepare_release,'ROOT',root),patch.object(prepare_release.subprocess,'check_output',side_effect=git),patch.object(prepare_release,'source_fingerprint',return_value='b'*64),patch.object(prepare_release,'public_key',return_value=key.public_key()),patch.object(release_contract,'public_key',return_value=key.public_key()):
                info=prepare_release.prepare(builds,output,keyfile,'v0.3.0-beta.4');release_contract.verify(info)
                self.assertEqual(json.loads((output/'dragon-c3.dragon.json').read_text())['format'],2)
                with self.assertRaises(ValueError):prepare_release.prepare(builds,output,keyfile,'v0.3.0-beta.4')
                (builds/'c3/provenance.json').write_text('{}')
                with self.assertRaises(ValueError):prepare_release.prepare(builds,root/'stale',keyfile,'v0.3.0-beta.4')
                self.assertFalse((root/'stale').exists())

    def test_usb_source_schema_missing_unknown_and_incompatible(self):
        recovery.compatible_source('v0.3.0-beta.3',None,1)
        recovery.compatible_source('v0.3.0',None,1)
        recovery.compatible_source('v0.3.0-beta.4',1,1)
        for tag,schema in [(None,None),('v0.4.0',None),('v0.4.0',2)]:
            with self.assertRaises(ValueError):recovery.compatible_source(tag,schema,1)

    def test_application_digest_verifies_bytes_not_just_tag(self):
        raw=b'\xe9'+b'\0'*22+b'\1'+b'example firmware'
        signed=raw+hashlib.sha256(raw).digest()
        self.assertEqual(recovery.image_app_digest(signed),hashlib.sha256(raw).hexdigest())
        with self.assertRaises(ValueError):recovery.image_app_digest(signed[:-1]+bytes([signed[-1]^1]))

    def test_online_signature_binds_release_tag(self):
        key=rsa.generate_private_key(public_exponent=65537,key_size=2048)
        pkg={'board':'s3','size':512,'sha256':'0'*64}
        manifest=sign_update.online_manifest(pkg,'v0.3.1',key)
        fields=manifest.splitlines();message='\n'.join(fields[:7])+'\n';signature=bytes.fromhex(fields[7])
        key.public_key().verify(signature,message.encode(),padding.PKCS1v15(),hashes.SHA256())
        with self.assertRaises(InvalidSignature):key.public_key().verify(signature,message.replace('v0.3.1','v0.3.2').encode(),padding.PKCS1v15(),hashes.SHA256())
        with self.assertRaises(ValueError):sign_update.online_manifest(pkg,'../../other',key)
    def test_partition_layout_preserves_nvs_and_two_slots(self):
        self.assertEqual(recovery.validate_partitions(partition_table())['nvs'],(1,2,0x9000,0x5000))
        recovery.validate_current_nvs(partition_table())
        with self.assertRaises(ValueError):recovery.validate_current_nvs(b'\xff'*4096)
        old=struct.pack('<HBBII16sI',0x50aa,0,0,0x10000,0x180000,b'app0',0)
        with self.assertRaises(ValueError):recovery.validate_partitions(old)
    def test_recovery_image_rejects_other_board_and_non_images(self):
        image=b'\xe9'+b'\0'*11+b'\x09\0'+b'\0'*10
        recovery.validate_image_target(image,'s3')
        for wrong in (b'',b'not an image',image[:12]+b'\x05\0'+image[14:]):
            with self.assertRaises(ValueError):recovery.validate_image_target(wrong,'s3')
    def test_installed_tool_does_not_require_arduino_cli(self):
        with tempfile.TemporaryDirectory() as temp:
            folder=Path(temp)/'Arduino15/packages/esp32/tools/esptool_py/5.0.dev1';folder.mkdir(parents=True)
            (folder/'esptool.exe').write_bytes(b'test')
            with patch.dict(recovery.os.environ,{'LOCALAPPDATA':temp}):self.assertEqual(recovery.installed_esptool(),folder/'esptool.exe')
    def test_no_probe_without_usb_only_confirmation(self):
        with patch.object(recovery,'detect_board') as detect:
            with self.assertRaises(ValueError):recovery.recover('cli','COM-test',False)
            detect.assert_not_called()
    def test_recovery_reads_and_verifies_nvs_without_writing_it(self):
        with tempfile.TemporaryDirectory() as temp:
            root=Path(temp);build=root/'bundle';build.mkdir()
            for f in recovery.FILES:(build/f).write_bytes(b'\xe9'+b'\0'*11+b'\x05\0'+b'\0'*10)
            (build/recovery.FILES[2]).write_bytes(partition_table());calls=[]
            original=bytes(range(256))*80
            def run(args,**kwargs):
                calls.append(args)
                if 'read-flash' in args:Path(args[-1]).write_bytes(partition_table() if args[args.index('read-flash')+1]=='0x8000' else original)
                return type('Result',(),{'returncode':0,'stderr':''})()
            with patch.object(recovery,'prepared_release',return_value={'firmware_tag':'v0.3.1','saved_schema':1}),patch.object(recovery,'check_source_compatibility'),patch.object(recovery,'release_image_digest',return_value='a'*64),patch.object(recovery,'ROOT',root),patch.object(recovery,'detect_board',return_value='c3'),patch.object(recovery,'load_bundle',return_value=build),patch.object(recovery,'esptool_path',return_value=Path('esptool')),patch.object(recovery.subprocess,'run',side_effect=run),patch.object(recovery,'check_startup') as startup:
                session=recovery.recover('cli','COM-test',True,lambda text:None)
            write=next(c for c in calls if 'write-flash' in c)
            self.assertEqual(write[write.index('write-flash')+1::2],['0x0','0x8000','0xe000','0x10000'])
            self.assertEqual((session/'nvs-before.bin').read_bytes(),(session/'nvs-after.bin').read_bytes())
            startup.assert_called_once()
    def test_startup_requires_expected_version_and_completed_validation(self):
        for version,validation,board,image,ota,success in [('v0.3.0-beta.2',0,'s3','a'*64,2,False),('v0.3.0-beta.1',1,'s3','a'*64,2,False),('v0.3.0-beta.2',1,'c3','a'*64,2,False),('v0.3.0-beta.2',1,'s3','b'*64,2,False),('v0.3.0-beta.2',1,'s3','',2,False),('v0.3.0-beta.2',1,'s3','a'*64,20,False),('v0.3.0-beta.2',1,'s3','a'*64,2,True)]:
            lines=iter([f'firmware_version={version} board={board}',f'firmware_image_sha256={image}',
                'library_ready=1 profile=0 profile_name=All',
                'dragon=blue name=Blue effects=0 presets=81',
                'uptime_ms=10000 session_max=400mA computer_usb_cap=1 voltage_sampling=stopped',
                'uptime_ms=12000 session_max=400mA computer_usb_cap=1 voltage_sampling=stopped',
                f'firmware_validation ready={validation} partition=app0 ota_state={ota}'])
            connection=Mock();connection.readline.side_effect=lambda:next(lines,'').encode()
            serial=SimpleNamespace(Serial=Mock(return_value=connection),SerialException=OSError)
            ports=SimpleNamespace(comports=lambda:[SimpleNamespace(device='COM-test',serial_number='test',vid=0x303a)])
            with patch.object(flash_support,'serial_modules',return_value=(serial,ports)),patch.object(flash_support.time,'monotonic',side_effect=itertools.count(100)):
                if success:flash_support.check_startup('COM-test',lambda text:None,timeout=20,expected_firmware='v0.3.0-beta.2',require_validation=True,expected_board='s3',expected_image_sha256='a'*64,production=True)
                else:
                    with self.assertRaises(RuntimeError):flash_support.check_startup('COM-test',lambda text:None,timeout=20,expected_firmware='v0.3.0-beta.2',require_validation=True,expected_board='s3',expected_image_sha256='a'*64,production=True)
            connection.close.assert_called_once()
    def test_recovery_gui_preflight_and_explicit_confirmation(self):
        import recovery_gui
        def descendants(widget):
            for child in widget.winfo_children():
                yield child
                yield from descendants(child)
        listing=SimpleNamespace(comports=lambda:[SimpleNamespace(device='COM-test')])
        with patch.object(recovery_gui,'prepared_release',return_value={'firmware_tag':'v0.3.0-beta.2'}),patch.object(recovery_gui,'installed_esptool',return_value=Path(__file__)),patch.object(recovery_gui,'serial_modules',return_value=(None,listing)),patch.object(recovery_gui,'recover') as flash:
            window=recovery_gui.create_window(visible=False,bundle_path=Path("simulated-bundle"))
            try:
                widgets=list(descendants(window));button=next(w for w in widgets if w.winfo_class()=='TButton' and w.cget('text')=='Update / recover firmware')
                port=next(w for w in widgets if w.winfo_class()=='TCombobox');port.set('COM-test')
                button.invoke();flash.assert_not_called() # Selecting a port alone cannot flash.
                safe=next(w for w in widgets if w.winfo_class()=='TCheckbutton');safe.invoke();button.invoke()
                for _ in range(200):
                    window.update();recovery.time.sleep(.002)
                    if not safe.instate(['selected']) and flash.called:break
                flash.assert_called_once();self.assertEqual(flash.call_args.args[1],'COM-test');self.assertTrue(flash.call_args.args[2]);self.assertFalse(safe.instate(['selected']))
                button.invoke();self.assertEqual(flash.call_count,1) # The next board needs confirmation again.
            finally:window.destroy()
        with patch.object(recovery_gui,'prepared_release',side_effect=ValueError('bad bundle')):
            window=recovery_gui.create_window(visible=False,bundle_path=Path("simulated-bundle"))
            try:
                button=next(w for w in descendants(window) if w.winfo_class()=='TButton' and w.cget('text')=='Update / recover firmware');self.assertTrue(button.instate(['disabled']))
            finally:window.destroy()
if __name__=='__main__':unittest.main()
