sai021/dragon-kingdom/(commit log)

2026-10-19 Fix live custom selection and retain minimum glow after S3 hardware tests
    [DragonPrototype.ino, test_sensors.cpp]
2026-10-19 Wait for Wi-Fi station readiness before enforcing radio power limit
2026-10-19 Adopt keeper edition with dragon-only editor and confirmed enclosure guide
2026-10-23 Add supplied STL, BOM and Gerber files with intake provenance
    [BOM_Dragon-Lamp_2_PCB1_1_2026-09-21.xlsx, BackCover 2.stl, LightGuide.stl, LithophaneJig.stl, Lithophanev2.stl, UsbNuts 2.stl, electronicsPlate.stl]
2026-10-23 Include native Fusion design with supplied hardware package
    [NightLamp.f3d]
2026-10-24 Add signed beta firmware updates, parent controls and contrasting glitter
    [partitions.csv]
2026-10-24 Show running firmware and prepare validated multi-board USB recovery
2026-10-24 Add persistent chip-bound divider calibration and validate corrected C3
    [DragonPrototype.ino, OnlinePolicy.h, VoltageCalibration.h, test_startup.cpp, test_voltage.cpp]
2026-10-24 Align shipping instructions and printable guides with current firmware
2026-10-24 Correct parent page layout and connection guidance; expose verified HTTPS diagnostics
    [DragonWeb.h, OnlinePolicy.h, OnlineTransport.h, test_release_tools.py]
2026-10-24 Group parent controls into dropdowns and show detected power mode; document backplate service
2026-10-25 Keep release handler fixtures newer than the shipping firmware
    [test_release.cpp]
2026-10-25 Publish family instructions and print PDFs for both Wi-Fi update modes
